Nick-Zhang1996/spinvtol/log/README.md

## Data Formatting
For run?.txt files, each entry is formatted as: time,x,y,z,rx,ry,rz,throttle,flap
For richrun?.txt files, each entry is formatted as: time,x,y,z,rx,ry,rz,throttle(PWM),flap(PWM),voltage(volt),isAutomaticControl(for future compatibility, 1 if using command over telemetry, 0 if using command from RC transmitter)

## Old Runfiles
new batt installed
run1: short, low hover, without vid
run2: longer low hover, with vid
run3: slight rising
run4: hover, pause for reposition, rising
battery drained at 3.77/cell

run5: starting at 4.2v, multiple ascend, hover, and descend
run6: 3.81V with flap partially down, ascend,hover, and descend
run7: 3.76V with flap fully down, ascend, hover, descend, end with 3.71v
run8: 4.2V full flap, multiple ascend, ...
run9: 3.96V, hover, then suddenly flap down
run10: 3.80V, hover, then suddenly throttle up
run11: 4.18 hover, then suddenly flapdown, end voltage 3.87

## New Richrun
Preferred runs (better data etc)
all used 250Hz vicon. 

13-16 are good runs
13: hover with mostly no flap deflection, moves up and down
14: some flap
