Nick-Zhang1996/spinvtol/pics/cdraw.png

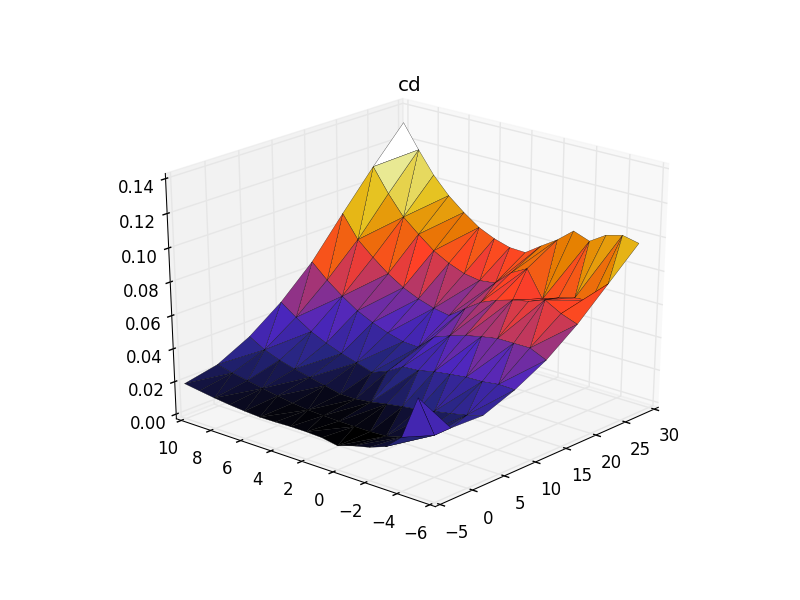
pics/cdraw.png
