Nick-Zhang1996/spinvtol/pics/clfit.png

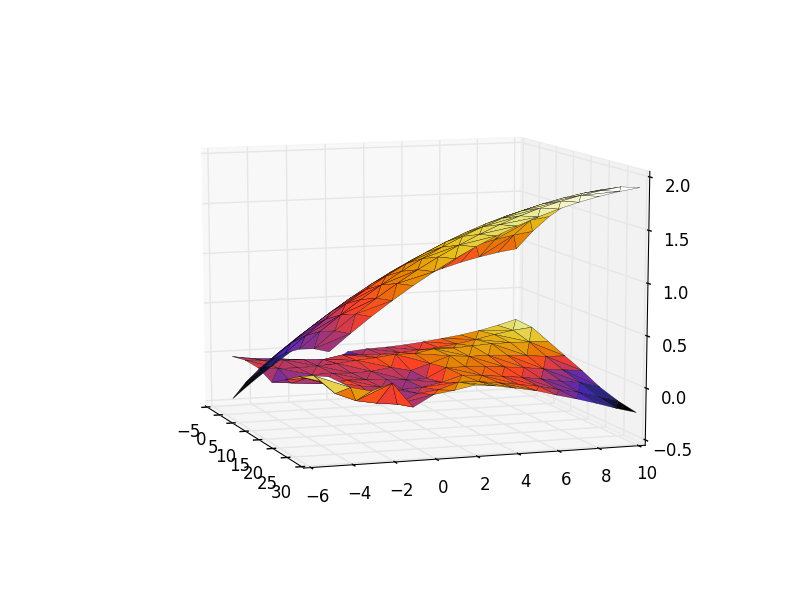
pics/clfit.png
