Nick-Zhang1996/spinvtol/pics/clraw.png

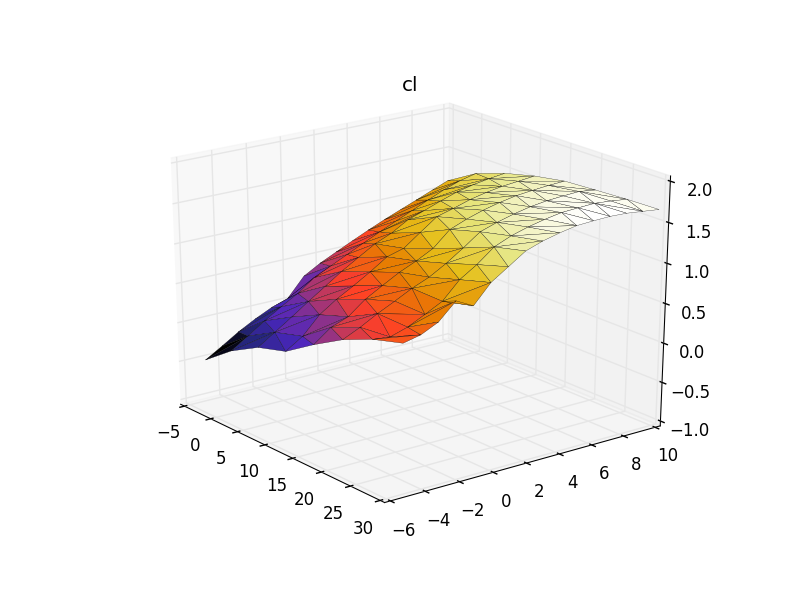
pics/clraw.png
