Nick-Zhang1996/spinvtol/pics/motor.png

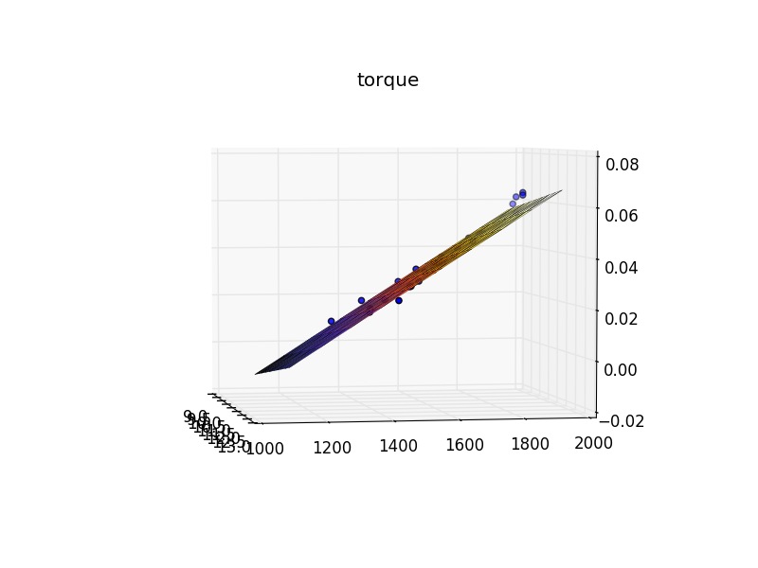
pics/motor.png
