Nick-Zhang1996/spinvtol/Arduino/teensyCyclicServo/teensyCyclicServo.ino

// this skwtch contains:
// 1. high speed servo controller with timer2. This sketch is able to control ppm on a per duty cycle basis
// 2. dual independent action sequence manager through timer 1
// the purpose of this skwtch is to test fast, frequent manipulation of timer settings and observe results

// actions
// Uses PDB timer
//#include <PWMServo.h>

// uses FTM0 timer by default, interferes with PWM function on some pins, see https://www.pjrc.com/teensy/td_pulse.html
#include <TeensyDelay.h>
#define NONE 0
#define LED_OFF 1
#define LED_ON 2

#define RISING_NEUTRAL 1
#define FALLING_NEUTRAL 3
#define SERVO_MIN 4
#define SERVO_MAX 2

#define PIN_LED 13
#define PIN_LED1 10
#define PIN_LED2 11
#define PIN_LED3 12
#define PIN_LED4 9

#define PIN_SERVO 14
#define PIN_TEST 3



#define MAX_SERVO_PULSEWIDTH 930
#define MIN_SERVO_PULSEWIDTH 560
#define CENTRAL_SERVO_PULSEWIDTH 745

// for testing PWM output on LEDs
//#define MAX_SERVO_PULSEWIDTH 3000
//#define MIN_SERVO_PULSEWIDTH 100
//#define CENTRAL_SERVO_PULSEWIDTH 1500

const float pi = 3.1415926535898;

float ffmod(float x, float y){
  return x-y*floor(x/y);
}

float fmap(float x, float in_min, float in_max, float out_min, float out_max) {
  return (x - in_min) * (out_max - out_min) / (in_max - in_min) + out_min;
}


//PWMServo myservo;

IntervalTimer blinkerTimer;
volatile byte pending_action_blinker = NONE;
volatile bool flash_in_progress = false;
volatile float on_time_ms = 20;

void blinker() {
    switch (pending_action_blinker){
        case LED_ON:
            digitalWrite(PIN_LED,HIGH);
            digitalWrite(PIN_LED1,LOW);
            digitalWrite(PIN_LED2,LOW);
            digitalWrite(PIN_LED3,LOW);
            pending_action_blinker = LED_OFF;
            blinkerTimer.begin(blinker,on_time_ms*1000);
            break;

        case LED_OFF:
            digitalWrite(PIN_LED,LOW);
            digitalWrite(PIN_LED1,HIGH);
            digitalWrite(PIN_LED2,HIGH);
            digitalWrite(PIN_LED3,HIGH);
            pending_action_blinker  = NONE;
            flash_in_progress = false;
            blinkerTimer.end();
            break;

        case NONE:
        default:
            break;
    }
} 


// ctrl_phase: phase to START command to max deflection
volatile float ctrl_phase;
// 0:azimuth, rad; 1:omega, rad/s
volatile float state_buffer[2];
// micros()
volatile unsigned long state_buffer_ts;
// us to next control phase, time between each new ISR
volatile float quarter_period;
volatile float current_phase;
volatile int pending_action_cyclic = NONE;
// TeensyDelay uses 16bit FTM timer that only goes to about 69ms, if we need a delay longer
// than that we need to handle this gracefully
volatile uint32_t remaining_delay_us;
void cyclic(){
  if (remaining_delay_us!=0){
    if (remaining_delay_us > 60000){
      TeensyDelay::trigger(60000,0);
      remaining_delay_us -= 60000;
    } else {
      TeensyDelay::trigger(remaining_delay_us);
      remaining_delay_us = 0;
    }
    return;
  }

  switch(pending_action_cyclic){

      case RISING_NEUTRAL:
          Serial.println("RISING_NEUTRAL");
          setPulseWidth(CENTRAL_SERVO_PULSEWIDTH);
          analogWrite(PIN_TEST,10);
          pending_action_cyclic = SERVO_MAX;
          // adjust control phase to sync with estimated state
          // 5e5 = 2(for 2pi) * 1e6 (sec -> us) / 4 (quarter period)
          quarter_period = 5e5*pi/state_buffer[1];
//XXX would micro() still work here?
          current_phase = state_buffer[0] + float(micros()-state_buffer_ts)*1e-6*state_buffer[1];
          remaining_delay_us = (ffmod(ctrl_phase-current_phase,2*pi)/state_buffer[1])*1e6;
          //Serial.print("current phase= ");
          //Serial.println(ffmod(current_phase,2*pi)/pi*180);
          //Serial.print("dist 2 ctrl phase= ");
          //Serial.println((ffmod(ctrl_phase-current_phase,2*pi))/pi*180);
          //Serial.print("wakeup after(s) ");
          //Serial.println((ffmod(ctrl_phase-current_phase,2*pi)/state_buffer[1]));
          //Serial.println(ffmod((ctrl_phase-current_phase)/2/pi,360));
          break;
          
      case SERVO_MAX:
          Serial.println("SERVO_MAX");
          setPulseWidth(MAX_SERVO_PULSEWIDTH);
          analogWrite(PIN_TEST,50);
          pending_action_cyclic = FALLING_NEUTRAL;
          remaining_delay_us = quarter_period;
          break;

      case FALLING_NEUTRAL:
          Serial.println("FALLING_NEUTRAL");
          setPulseWidth(CENTRAL_SERVO_PULSEWIDTH);
          analogWrite(PIN_TEST,150);
          pending_action_cyclic = SERVO_MIN;
          remaining_delay_us = quarter_period;
          break;

      case SERVO_MIN:
          Serial.println("SERVO_MIN");
          setPulseWidth(MIN_SERVO_PULSEWIDTH);
          analogWrite(PIN_TEST,200);
          pending_action_cyclic  = RISING_NEUTRAL;
          remaining_delay_us = quarter_period;
          break;

      case NONE:
      default:
          //Serial.println("fallthrough");
          break;
  }

  if (remaining_delay_us > 60000){
    TeensyDelay::trigger(60000,0);
    remaining_delay_us -= 60000;
  } else {
    TeensyDelay::trigger(remaining_delay_us);
    remaining_delay_us = 0;
  }
  return;
} 


int min_us = MIN_SERVO_PULSEWIDTH;
int max_us = MAX_SERVO_PULSEWIDTH;

volatile uint32_t oldres;
volatile int duty;
void setPulseWidth(float us)
{
  if (us<min_us) { us = min_us; }
  if (us>max_us) { us = max_us; }
	duty = us/(1e6/300.0)*65535;
#if TEENSYDUINO >= 137
	noInterrupts();
	oldres = analogWriteResolution(16);
	analogWrite(PIN_SERVO, duty);
  // restore resolution
	analogWriteResolution(oldres);
	interrupts();
#endif
}

volatile bool light_on = false;
void test(){
    if (!light_on){
      digitalWrite(13,HIGH);
      TeensyDelay::trigger(60e3,1);
      light_on = true;
    } else{
      digitalWrite(13,LOW);
      TeensyDelay::trigger(20e3,1);
      light_on = false;
    }
}
      
uint8_t rc_in_pinno[] = {4, 5, 6, 7, 8}; // CH0,1,2,3,4
volatile int rc_in_val[5] = {0};
volatile unsigned long rc_rising_ts[5] = {0};
bool flag_signal_loss = false;

//note: measured dutycycle for futaba FHSS 13564us, 73Hz
void rc0_in_callback() {
  unsigned long timestamp = micros();
  if (digitalRead(rc_in_pinno[0]) == HIGH) {
    rc_rising_ts[0] = timestamp;
  } else {
    rc_in_val[0] = timestamp - rc_rising_ts[0];
  }
}
void rc1_in_callback() {
  unsigned long timestamp = micros();
  if (digitalRead(rc_in_pinno[1]) == HIGH) {
    rc_rising_ts[1] = timestamp;
  } else {
    rc_in_val[1] = timestamp - rc_rising_ts[1];
  }
}
void rc2_in_callback() {
  unsigned long timestamp = micros();
  if (digitalRead(rc_in_pinno[2]) == HIGH) {
    rc_rising_ts[2] = timestamp;
  } else {
    rc_in_val[2] = timestamp - rc_rising_ts[2];
  }
}
void rc3_in_callback() {
  unsigned long timestamp = micros();
  if (digitalRead(rc_in_pinno[3]) == HIGH) {
    rc_rising_ts[3] = timestamp;
  } else {
    rc_in_val[3] = timestamp - rc_rising_ts[3];
  }
}
void rc4_in_callback() {
  unsigned long timestamp = micros();
  if (digitalRead(rc_in_pinno[4]) == HIGH) {
    rc_rising_ts[4] = timestamp;
  } else {
    rc_in_val[4] = timestamp - rc_rising_ts[4];
  }
}


void setup() {
    // put your setup code here, to run once:
    Serial.begin(115200);
    pinMode(PIN_LED,OUTPUT);
    pinMode(PIN_LED1,OUTPUT);
    pinMode(PIN_LED2,OUTPUT);
    pinMode(PIN_LED3,OUTPUT);
    pinMode(PIN_LED4,OUTPUT);
    pinMode(PIN_TEST,OUTPUT);
    digitalWrite(PIN_LED, LOW);

    pinMode(PIN_SERVO,OUTPUT);
    analogWriteFrequency(PIN_SERVO, 300);

    pinMode(13,OUTPUT);
    //rad
    state_buffer[0] = 0;
    // rad/s
    state_buffer[1] = 2*pi;
    state_buffer_ts = 0;
    //myservo.attach(PIN_SERVO,560,930);

    pending_action_cyclic = RISING_NEUTRAL;
    blinkerTimer.begin(blinker,1e6);
    TeensyDelay::begin();
    TeensyDelay::addDelayChannel(cyclic, 0);
    //TeensyDelay::addDelayChannel(test, 1);
    TeensyDelay::trigger(10,0);
    //TeensyDelay::trigger(10,1);

    for (int i = 0; i < sizeof(rc_in_pinno) / sizeof(uint8_t);  i++) {
      pinMode(rc_in_pinno[i], INPUT);
    }
    attachInterrupt( digitalPinToInterrupt(rc_in_pinno[0]), rc0_in_callback, CHANGE);
    attachInterrupt( digitalPinToInterrupt(rc_in_pinno[1]), rc1_in_callback, CHANGE);
    attachInterrupt( digitalPinToInterrupt(rc_in_pinno[2]), rc2_in_callback, CHANGE);
    attachInterrupt( digitalPinToInterrupt(rc_in_pinno[3]), rc3_in_callback, CHANGE);
    attachInterrupt( digitalPinToInterrupt(rc_in_pinno[4]), rc4_in_callback, CHANGE);
    
}

void loop() {
  // put your main code here, to run repeatedly:
    if (Serial.available()>0) {
        float val = Serial.parseFloat();
        cli();
        // set speed, rev/s
        state_buffer[1] = val*2*pi;
        sei();
        Serial.print(val);
        //Serial.print("  ");
        //Serial.println(fmap(val,0,100,MIN_SERVO_PULSEWIDTH,MAX_SERVO_PULSEWIDTH));
        Serial.println();

        pending_action_blinker = LED_ON;
        if (!flash_in_progress){
          // time needed to travel 10 degrees, so that light will be on for 10 deg
          //on_time_ms = 10.0/180.0*pi/x[1][0]*1000.0;
          // XXX a bit hacky, but probably OK
          on_time_ms = 3000;
          float blink_delay = 1000;
          if (blink_delay>0){
            flash_in_progress = true;
            pending_action_blinker = LED_ON;
            blinkerTimer.begin(blinker,blink_delay*1000);
          }
        }
    }
    //block -- serial update
    static int serial_update_freq = 10;
    static unsigned long serial_update_ts = millis();
    if ( (millis() - serial_update_ts) > (unsigned long) (1000 / float(serial_update_freq)) ) {
      serial_update_ts = millis();
        Serial.print(F("RC in : ch0 : "));
        Serial.print(rc_in_val[0]);
        Serial.print(F(" | ch1 : "));
        Serial.print(rc_in_val[1]);
        Serial.print(F(" | ch2 : "));
        Serial.print(rc_in_val[2]);
        Serial.print(F(" | ch3 : "));
        Serial.println(rc_in_val[3]);
    }
    // block ----
    delay(10);

}
