Nick-Zhang1996/spinvtol/Arduino/MPU9250_DMP_Quaternion/MPU9250_DMP_Quaternion.ino

/************************************************************
MPU9250_DMP_Quaternion
 Quaternion example for MPU-9250 DMP Arduino Library 
Jim Lindblom @ SparkFun Electronics
original creation date: November 23, 2016
https://github.com/sparkfun/SparkFun_MPU9250_DMP_Arduino_Library

The MPU-9250's digital motion processor (DMP) can calculate
four unit quaternions, which can be used to represent the
rotation of an object.

This exmaple demonstrates how to configure the DMP to 
calculate quaternions, and prints them out to the serial
monitor. It also calculates pitch, roll, and yaw from those
values.

Development environment specifics:
Arduino IDE 1.6.12
SparkFun 9DoF Razor IMU M0

Supported Platforms:
- ATSAMD21 (Arduino Zero, SparkFun SAMD21 Breakouts)
*************************************************************/
#include <SparkFunMPU9250-DMP.h>

#define SerialPort SerialUSB

MPU9250_DMP imu;
const float pi=3.14159;
const float rad2deg = 180/pi;



void setup() 
{
  SerialPort.begin(115200);

  // Call imu.begin() to verify communication and initialize
  if (imu.begin() != INV_SUCCESS)
  {
    while (1)
    {
      SerialPort.println("Unable to communicate with MPU-9250");
      SerialPort.println("Check connections, and try again.");
      SerialPort.println();
      delay(5000);
    }
  }
  
  imu.dmpBegin(DMP_FEATURE_6X_LP_QUAT | // Enable 6-axis quat
               DMP_FEATURE_GYRO_CAL, // Use gyro calibration
              10); // Set DMP FIFO rate to 10 Hz
  // DMP_FEATURE_LP_QUAT can also be used. It uses the 
  // accelerometer in low-power mode to estimate quat's.
  // DMP_FEATURE_LP_QUAT and 6X_LP_QUAT are mutually exclusive
}

float roll,pitch,yaw;
unsigned long ts;

void loop() 
{
  // Check for new data in the FIFO
  if ( imu.fifoAvailable() )
  {
    // Use dmpUpdateFifo to update the ax, gx, mx, etc. values
    if ( imu.dmpUpdateFifo() == INV_SUCCESS)
    {
      // computeEulerAngles can be used -- after updating the
      // quaternion values -- to estimate roll, pitch, and yaw
      ts = millis();
      imu.computeEulerAngles();
      printIMUData();
    }
  }
  
}

void printIMUData(void)
{  
  // After calling dmpUpdateFifo() the ax, gx, mx, etc. values
  // are all updated.
  // Quaternion values are, by default, stored in Q30 long
  // format. calcQuat turns them into a float between -1 and 1
  float q0 = imu.calcQuat(imu.qw);
  float q1 = imu.calcQuat(imu.qx);
  float q2 = imu.calcQuat(imu.qy);
  float q3 = imu.calcQuat(imu.qz);

  // convert to euler angles
  // roll (x-axis rotation)
  float sinr_cosp = +2.0 * (q0 * q1 + q2 * q3);
  float cosr_cosp = +1.0 - 2.0 * (q1 * q1 + q2 * q2);
  roll = atan2(sinr_cosp, cosr_cosp);

  // pitch (y-axis rotation)
  float sinp = +2.0 * (q0 * q2 - q3 * q1);
  if (fabs(sinp) >= 1)
      pitch = (sinp>0) ? pi/2:-pi/2; // use 90 degrees if out of range
  else
      pitch = asin(sinp);

  // yaw (z-axis rotation)
  float siny_cosp = +2.0 * (q0 * q3 + q1 * q2);
  float cosy_cosp = +1.0 - 2.0 * (q2 * q2 + q3 * q3);  
  yaw = atan2(siny_cosp, cosy_cosp);

  SerialPort.println("roll,pitch,yaw: " + String(rad2deg*roll, 2) + ", " +
                    String(rad2deg*pitch, 2) + ", " + String(rad2deg*yaw, 2));

  //SerialPort.println("Q: " + String(q0, 4) + ", " +
  //                  String(q1, 4) + ", " + String(q2, 4) + 
  //                  ", " + String(q3, 4));
  //SerialPort.println("R/P/Y: " + String(imu.roll) + ", "
  //          + String(imu.pitch) + ", " + String(imu.yaw));
  //SerialPort.println("Time: " + String(imu.time) + " ms");
  SerialPort.println();

}
