Nick-Zhang1996/spinvtol/(commit log)

2019-06-21 save before next day
    pending: put all print string to flash
2019-06-21 add serial command
    switch display on and off
2019-06-21 add led
2019-06-28 fix rssi minior issue
    [monocopter.ino]
2019-06-29 finished Kalman filter pending testing
2019-06-30 working Kalman Filter
2019-07-04 100Hz magmeter
2019-07-11 fix bugs in EKF
    [monocopter.ino, testStand.ino]
2019-07-16 fast servo ctrl
2019-07-17 fix time unit err
    [highSpeedServo.ino, monocopter.ino]
2019-07-18 fixed bad bit clearing syntax
    [monocopter.ino]
2019-07-18 servo output fix
2019-07-27 add PWMservo
2019-07-27 switch to my fork
2019-07-28 new test case
2019-07-29 test servo
2019-07-30 TeensyDelay test
2019-07-30 working servo code
2019-07-31 Migrate to teensy 3.5, compilabe untested
2019-07-31 fix some compiler warning
    [teensyMonocopter.ino]
2019-08-09 fix floating central reference for servo cyclic control
    [monocopter.ino]
2019-08-15 lock freq to 300Hz
2020-02-14 throttle update rate to 300hz
2020-02-14 shorter samples
2020-02-23 throttle relay and channel adj
2020-02-23 add telemetry ctrl, voltage, failsafe, etc
    [teensyMonocopter.ino]
2020-02-24 update ground station
2020-02-24 Added teensy fake data simulation
2020-02-26 update multi-thread example
2020-03-03 motor pic
2020-03-06 cvt 2 pwm
2020-03-12 binary protocol w/ misalignment detection
    [binaryComm.ino, bings.py, bintest.py, teensyBin.ino]
2020-04-26 Mbed version of the code
    Works slightly better than the Arduino version; also has a C# GUI written in Visual Studio
